ishika2603/human-dj/docs/demo_flyer.pdf

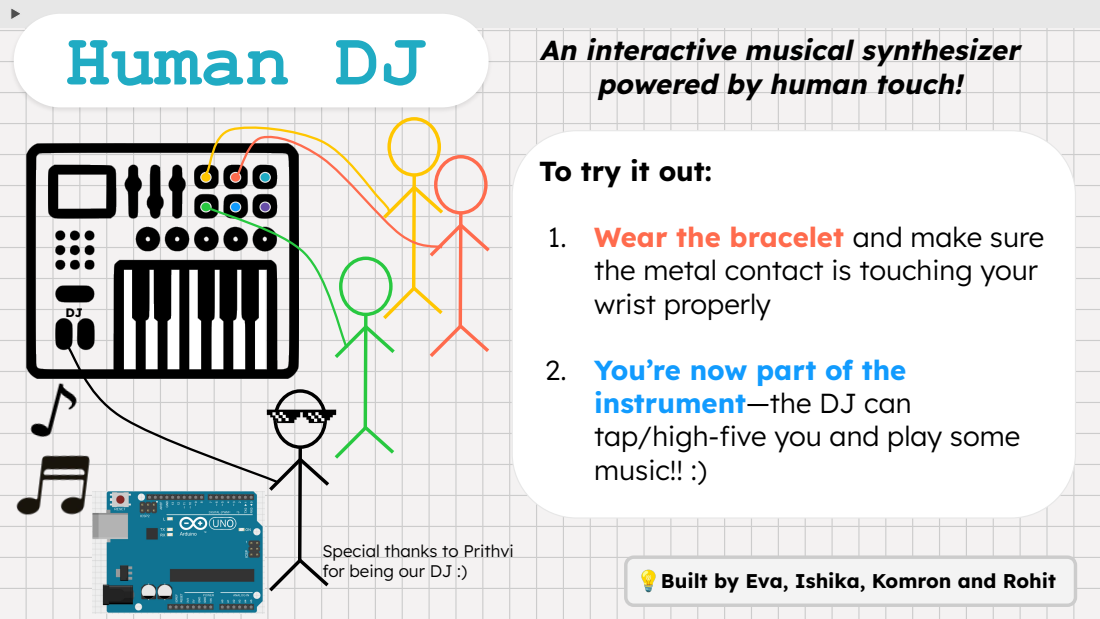
[picture p8: page 1]
Human; An interactive musical synthesizer

powered by human touch!

To try it out:

1. Wear the bracelet and make sure
the metal contact is touching your
wrist properly

2. You’re now part of the
instrument—the DJ can
tap/high-five you and play some
music!! :)

Special thanks to Prithvi
for being our DJ :)

💡Built by Eva, Ishika, Komron and Rohit
