ishika2603/human-dj/humandj/humandj_tests.ino

/*
 * For human dj fsm testing
 */
#ifdef TESTING

/*        
 * Helper function for printing states
 */
char* s2str(state s) {
  switch(s) {
    case sINIT:
        return "(1) INIT";
    case sWAIT_FOR_CHANGE:
        return "(2) WAIT_FOR_CHANGE";
    case sSEND_SIGNAL:
        return "(3) SEND_SIGNAL";
    default:
        return "INVALID_STATE";
  }
}

/*
 * Helper function for printing arrays
 */
void printArray(int* arr, int size) {
    Serial.print("[");
    for (int i = 0; i < size; i++) {
        Serial.print(arr[i]);

        if (i != size - 1) {
            Serial.print(", ");
        }
    }
    Serial.print("]");
}

/*
 * Helper function for asserting values
 */
void assertBool(bool b) {
    if (!b) {
        Serial.println("Assertion failed!");
        while (true); // hang if assertion fails
    }
}


/*
 * Test for FSM transitions
 */
bool testTransition(state startState,
                    state endState,
                    state_inputs testStateInputs, 
                    state_vars startStateVars,
                    state_vars endStateVars) {
    // set variables
    for (int i = 0; i < NUM_PEOPLE; i++) {
        midiVector[i] = startStateVars.midi_states[i];
    }
    signalSent = startStateVars.signal_sent;

    // run the FSM
    state resultState = updateFSM(startState, testStateInputs.touch_states, testStateInputs.fader_states);

    // check the results
    bool passed_test = ((resultState == endState) and (signalSent == endStateVars.signal_sent));
    for (int i = 0; i < NUM_PEOPLE; i++) {
        passed_test = passed_test and (midiVector[i] == endStateVars.midi_states[i]);
    }

    if (passed_test) {
        Serial.print("[FSM] test from (");
        Serial.print(s2str(startState));
        Serial.print(" -> ");
        Serial.print(s2str(endState));
        Serial.println(") passed");
    } else {
        Serial.print("[FSM] test from (");
        Serial.print(s2str(startState));
        Serial.print(" -> ");
        Serial.print(s2str(endState));
        Serial.println(") failed");
    }

    #ifdef DEBUG

    if (!passed_test) {
        // print out the states
        Serial.print("> end state expected: ");
        Serial.print(s2str(endState));
        Serial.print(" but got: ");
        Serial.println(s2str(resultState));

        // print out the inputs
        Serial.print("> inputs:   touch_states: ");
        printArray(testStateInputs.touch_states, NUM_PEOPLE);
        Serial.print(" | fader_states: ");
        printArray(testStateInputs.fader_states, 2);
        Serial.println();
        
        // print out the variables
        Serial.print("> expected: midi_states: ");
        printArray(endStateVars.midi_states, NUM_PEOPLE);
        Serial.print(" | signal_sent: ");
        Serial.print(endStateVars.signal_sent);
        Serial.println();
        Serial.print("> actual:   midi_states: ");
        printArray(midiVector, NUM_PEOPLE);
        Serial.print(" | signal_sent: ");
        Serial.print(signalSent);
        Serial.println();
    }
    #endif

    return passed_test;
}

const int numTests = 8;

const char* testNames[numTests] = {
    "initialization always finishes",
    "if nobody ever touches, keeps waiting",
    "if one person holds touch, keeps waiting",
    "if participant stops touching, sends signal",
    "if participant starts touching, sends signal",
    "if two participants change state, sends signal",
    "if note is not played, try sending signal again",
    "after note is played, wait for change",
};

const state testStatesIn[numTests] = {
    sINIT,
    sWAIT_FOR_CHANGE,
    sWAIT_FOR_CHANGE,
    sWAIT_FOR_CHANGE,
    sWAIT_FOR_CHANGE,
    sWAIT_FOR_CHANGE,
    sSEND_SIGNAL,
    sSEND_SIGNAL,
};
const state testStatesOut[numTests] = {
    sWAIT_FOR_CHANGE,
    sWAIT_FOR_CHANGE,
    sWAIT_FOR_CHANGE,
    sSEND_SIGNAL,
    sSEND_SIGNAL,
    sSEND_SIGNAL,
    sSEND_SIGNAL,
    sWAIT_FOR_CHANGE,
};
const state_inputs testInputs[numTests] = {
    {.touch_states = {0, 0, 0, 0}, .fader_states = {0, 0}},
    {.touch_states = {0, 1, 0, 1}, .fader_states = {0, 0}},
    {.touch_states = {1, 0, 0, 0}, .fader_states = {0, 0}},
    {.touch_states = {1, 1, 0, 1}, .fader_states = {0, 0}},
    {.touch_states = {1, 0, 0, 0}, .fader_states = {0, 0}},
    {.touch_states = {1, 1, 0, 0}, .fader_states = {0, 0}},
    {.touch_states = {0, 0, 0, 0}, .fader_states = {0, 0}},
    {.touch_states = {0, 0, 0, 0}, .fader_states = {0, 0}},
};
const state_vars testVarsIn[numTests] = {
    {.midi_states = {0, 0, 0, 0}, .signal_sent = false},
    {.midi_states = {0, 1, 0, 1}, .signal_sent = false},
    {.midi_states = {1, 0, 0, 0}, .signal_sent = false},
    {.midi_states = {1, 1, 1, 1}, .signal_sent = false},
    {.midi_states = {0, 0, 0, 0}, .signal_sent = false},
    {.midi_states = {0, 1, 1, 0}, .signal_sent = false},
    {.midi_states = {0, 0, 0, 0}, .signal_sent = false},
    {.midi_states = {0, 0, 0, 0}, .signal_sent = true},
};
const state_vars testVarsOut[numTests] = {
    {.midi_states = {0, 0, 0, 0}, .signal_sent = false},
    {.midi_states = {0, 1, 0, 1}, .signal_sent = false},
    {.midi_states = {1, 0, 0, 0}, .signal_sent = false},
    {.midi_states = {1, 1, 1, 1}, .signal_sent = false},
    {.midi_states = {0, 0, 0, 0}, .signal_sent = false},
    {.midi_states = {0, 1, 1, 0}, .signal_sent = false},
    {.midi_states = {0, 0, 0, 0}, .signal_sent = true},
    {.midi_states = {0, 0, 0, 0}, .signal_sent = true},
};


/*
 * Runs through all the FSM tests
 */
void testAllTests() {
    Serial.println("Running all FSM tests...");

    for (int i = 0; i < numTests; i++) {
        if (!testTransition(testStatesIn[i], testStatesOut[i], testInputs[i], testVarsIn[i], testVarsOut[i])) {
            while (true); // hang if test fails
        }
    }
    Serial.println("All FSM tests passed!");
}

/*
 * Runs all the unit tests
 */
void runUnitTests() {
    Serial.println("Running all unit tests...");
    test_send_signal();
    test_send_onboard_note();
    test_update_fader_states();
    test_calibrate_voltage();
    test_update_touch_states();
    Serial.println("All unit tests passed!");
}

#endif
