ishika2603/human-dj/(commit log)

2024-11-23 music improvements: pitch, send_signal and more
2024-12-04 fix: running on arduino
    [humandj.ino, touch_sense.ino]
2024-12-06 touch sense plotting and calibration, and ISR
2024-12-08 feat: basic on board player
2024-12-11 capstone functionality for pitch bend
2024-12-11 fix: pitch bend for midi
    [music.ino, onboard_player.ino, touch_sense.ino]
2024-12-11 fix: current testing compiles
    [sliders.ino, touch_sense.ino]
